S-Kiyomi/Arduino-Based-Digital-Hot-Air-Station/REWORK_STS_rev2/Solder-uap-digital-v1.kicad_pcb

## KiCad design REWORK_STS_rev2/Solder-uap-digital-v1.kicad_pcb (2026-10-26, last stored version)

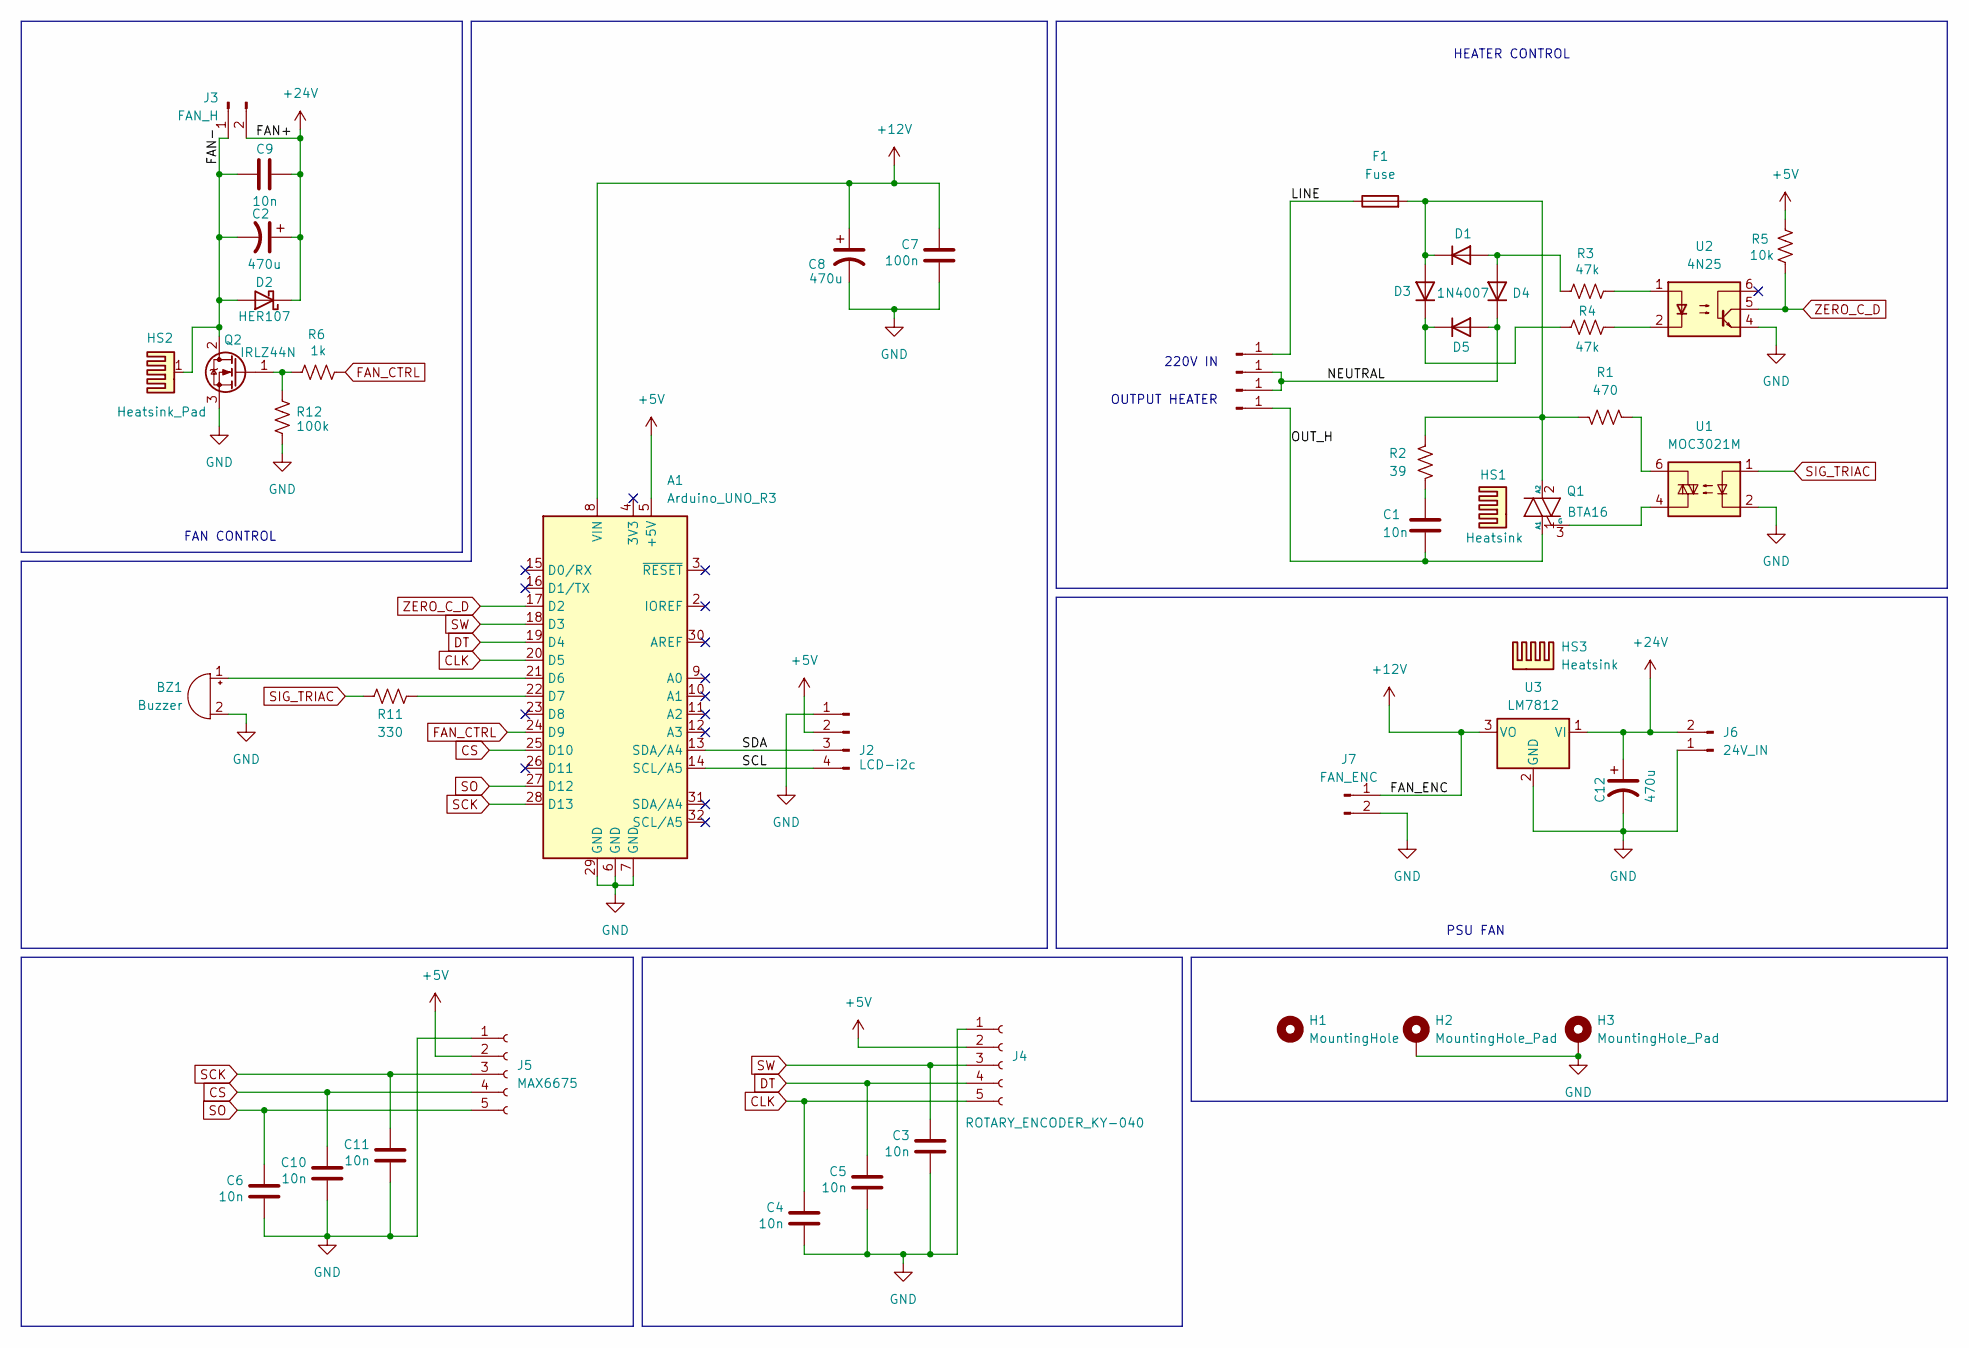
[picture p4: schematic Solder-uap-digital-v1.kicad_sch]

Parts:
A1: Arduino_UNO_R3
BZ1: Buzzer; Buzzer_12x9.5RM7.6
C1: 10n; C_Rect_L19.0mm_W7.0mm_P15.00mm_MKS4
C2, C8, C12: 470u; CP_Radial_D10.0mm_P3.50mm
C3, C4, C5, C6, C9, C10, C11: 10n; C_Disc_D9.0mm_W5.0mm_P10.00mm
C7: 100n; C_Disc_D9.0mm_W5.0mm_P10.00mm
D1, D3, D4, D5: 1N4007; D_DO-41_SOD81_P10.16mm_Horizontal
D2: HER107; D_A-405_P10.16mm_Horizontal
F1: Fuse; Fuseholder_Clip-5x20mm_Eaton_1A5601-01_Inline_P20.80x6.76mm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
H1: MountingHole; MountingHole_2.5mm_Pad
H2, H3: MountingHole_Pad; MountingHole_2.5mm_Pad
HS1: Heatsink; Heatsink_Fischer_SK129-STS_42x25mm_2xDrill2.5mm
HS2: Heatsink_Pad; Heatsink_AAVID_Extruded_531102B02100G_34.9x12.7mm_H38.1mm
HS3: Heatsink; Heatsink_Stonecold_HS-S01_13.21x6.35mm
J1, J8, J9, J10: Conn_01x01_Pin; SolderWire-0.75sqmm_1x01_D1.25mm_OD3.5mm
J2: LCD-i2c; PinHeader_1x04_P2.54mm_Vertical
J3: FAN_H; Molex_KK-254_AE-6410-02A_1x02_P2.54mm_Vertical
J4: ROTARY_ENCODER_KY-040; PinHeader_1x05_P2.54mm_Vertical
J5: MAX6675; PinHeader_1x05_P2.54mm_Vertical
J6: 24V_IN; Molex_KK-254_AE-6410-02A_1x02_P2.54mm_Vertical
J7: FAN_ENC; Molex_KK-254_AE-6410-02A_1x02_P2.54mm_Vertical
Q1: BTA16; TO-220-3_Vertical
Q2: IRLZ44N; TO-220-3_Vertical
R1: 470; R_Axial_DIN0309_L9.0mm_D3.2mm_P12.70mm_Horizontal
R2: 39; R_Axial_DIN0309_L9.0mm_D3.2mm_P12.70mm_Horizontal
R3, R4: 47k; R_Axial_DIN0309_L9.0mm_D3.2mm_P12.70mm_Horizontal
R5: 10k; R_Axial_DIN0309_L9.0mm_D3.2mm_P12.70mm_Horizontal
R6: 1k; R_Axial_DIN0309_L9.0mm_D3.2mm_P12.70mm_Horizontal
R11: 330; R_Axial_DIN0309_L9.0mm_D3.2mm_P12.70mm_Horizontal
R12: 100k; R_Axial_DIN0309_L9.0mm_D3.2mm_P12.70mm_Horizontal
U1: MOC3021M; DIP-6_W10.16mm_LongPads
U2: 4N25; DIP-6_W7.62mm
U3: LM7812; TO-220-3_Vertical

Connections:
+5V: A1.5 (+5V), J2.2, J4.2, J5.2, R5.1
+12V: A1.8 (VIN), C7.1, C8.1, J7.1, U3.3 (VO)
+24V: C2.1, C9.2, C12.1, D2.1 (K), J3.2, J6.2, U3.1 (VI)
/FAN-: C2.2, C9.1, D2.2 (A), HS2.1, J3.1, Q2.2 (D)
/LINE: F1.1, J1.1 (Pin_1_1)
/NEUTRAL: D4.1 (K), D5.2 (A), J8.1 (Pin_1_1), J9.1 (Pin_1_1)
/OUT_H: C1.2, J10.1 (Pin_1_1), Q1.1 (A1)
/SCL: A1.14 (SCL/A5), J2.4
/SDA: A1.13 (SDA/A4), J2.3
CLK: A1.20 (D5), C4.1, J4.5
CS: A1.25 (D10), C10.1, J5.4
DT: A1.19 (D4), C5.1, J4.4
FAN_CTRL: A1.24 (D9), R6.1
GND: A1.6 (GND), A1.7 (GND), A1.29 (GND), BZ1.2 (-), C3.2, C4.2, C5.2, C6.2, C7.2, C8.2, C10.2, C11.2, C12.2, H2.1 (1_1), H3.1 (1_1), J2.1, J4.1, J5.1, J6.1, J7.2, Q2.3 (S), R12.2, U1.2, U2.4, U3.2 (GND)
unnamed: A1.21 (D6), BZ1.1 (+)
unnamed: A1.22 (D7), R11.1
unnamed: C1.1, R2.1
unnamed: D1.2 (A), D4.2 (A), R3.2
unnamed: D1.1 (K), D3.2 (A), F1.2, Q1.2 (A2), R1.2, R2.2
unnamed: D3.1 (K), D5.1 (K), R4.2
unnamed: Q1.3 (G), U1.4
unnamed: Q2.1 (G), R6.2, R12.1
unnamed: R1.1, U1.6
unnamed: R3.1, U2.1
unnamed: R4.1, U2.2
SCK: A1.28 (D13), C11.1, J5.3
SIG_TRIAC: R11.2, U1.1
SO: A1.27 (D12), C6.1, J5.5
SW: A1.18 (D3), C3.1, J4.3
ZERO_C_D: A1.17 (D2), R5.2, U2.5

Notes on the sheet:
FAN CONTROL
HEATER CONTROL
PSU FAN
220V IN
OUTPUT HEATER

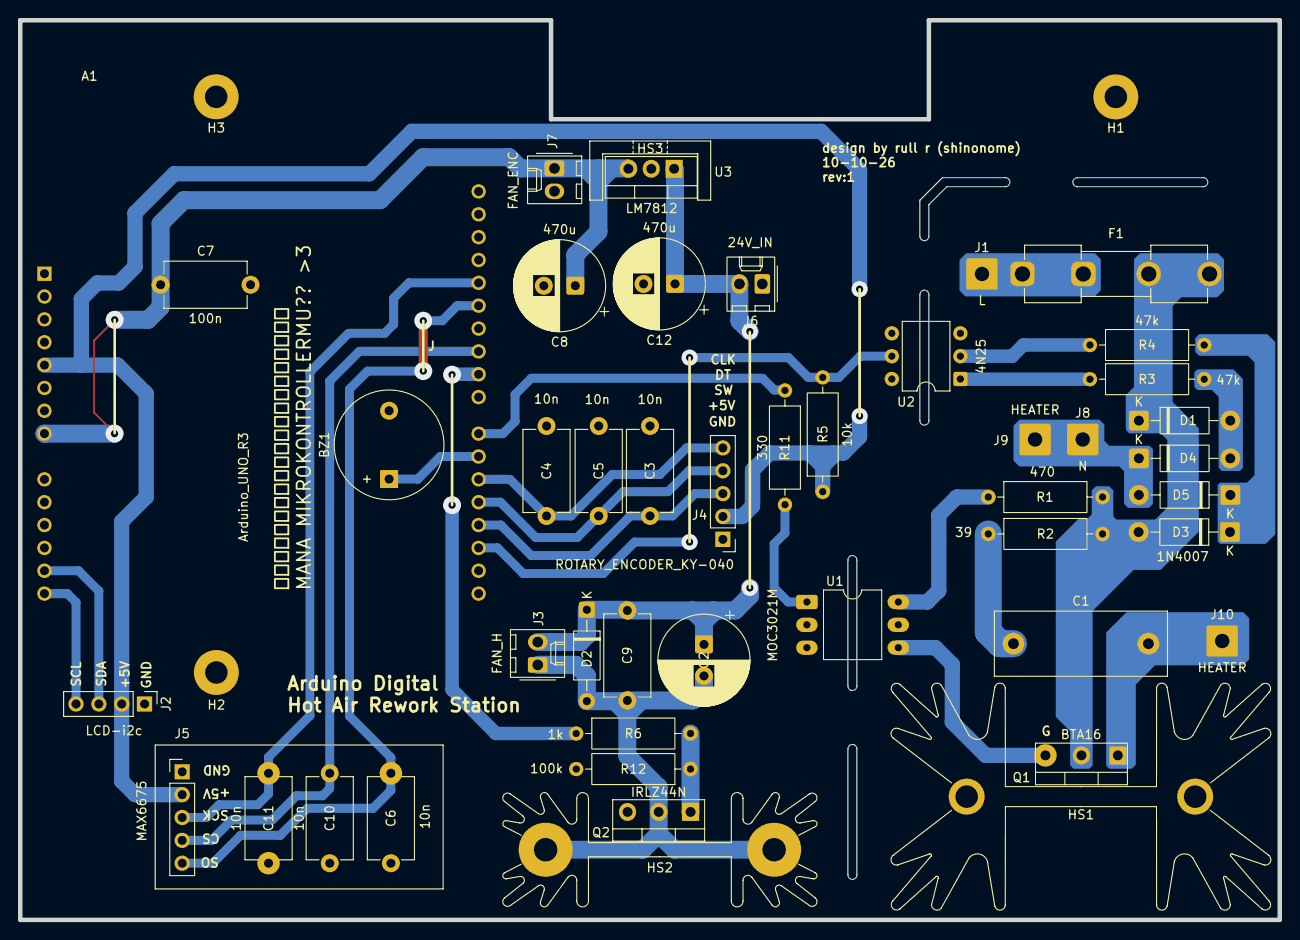
[picture p5: board Solder-uap-digital-v1.kicad_pcb from above]

Board: 2 copper layers, 140.0 x 100.0 mm, 49 parts (1 on the bottom side), 30 nets.
