S-Kiyomi/Arduino-Based-Digital-Hot-Air-Station/(commit log)

2026-10-24 Revise README for Hot-Air Rework Station project
    Updated project title and added sections for features, system diagram, schematic, and contribution guidelines.
2026-10-24 Update README with project description and warnings
    Added project details and warning about high voltage.
2026-10-26 refactor(firmware): release v2.0 firmware for 858D hot-air station
    - Invert handle switch polarity to HIGH for tilt sensor integration.
    - Implement step rounding/snapping on rapid rotary encoder rotation.
    - Consolidate core system logic and PID loops into updateSystemLogic().
    - Optimize LCD 16x2 layout, fixed-width status strings, and localized menu prompts.
    - Streamline MAX6675 thermocouple fault handling on boot up.
    - Fix dynamic LCD status refresh bug when dropping below ready temperature band.
2026-10-27 Fix LCD backlight display bug
    Fix display issue by updating backlight handling logic.
    [UI.cpp]
2026-10-27 Fix MAX_SO pin initialization and temp validation
    Fixed initialization of MAX_SO pin and adjusted temperature validation range.
    [Hardware.cpp]
2026-10-27 fix bug max6675 reading error
    [Hardware.cpp]
2026-10-28 fix mismatch pin & add comment on the clear LCD feature(UI.cpp)
    [Config.h, UI.cpp]
2026-10-28 change handle on holder logic for magnetic sensor version
2026-10-28 Update sensor terminology in README.md
2026-11-01 refactor(firmware): migrate to pure AVR bare-metal architecture (v2.0)
    - Remove Arduino core dependencies (Wire.h, LiquidCrystal_I2C.h, EEPROM.h)
    - Implement bare-metal TWI (I2C) LCD driver and hardware SPI for MAX6675
    - Implement raw register I/O, Timer1 Fast PWM (Fan), and Timer0 SysTick
    - Add bare-metal EEPROM handling for targetTempC and fanPercent persistence
    - Optimize RAM/Flash using PROGMEM strings and custom integer formatters
    - Update README.md with v2.0 hardware specs and architectural changes
