S-Kiyomi/Arduino-Based-Digital-Hot-Air-Station/(notices)

Notices in the files:
README.md:
License: MIT
